chacal/pcbs/MS88SF2 eInk display/MS88SF2 eInk display v2.kicad_pcb

## KiCad design MS88SF2 eInk display/MS88SF2 eInk display v2.kicad_pcb (2021-03-07)

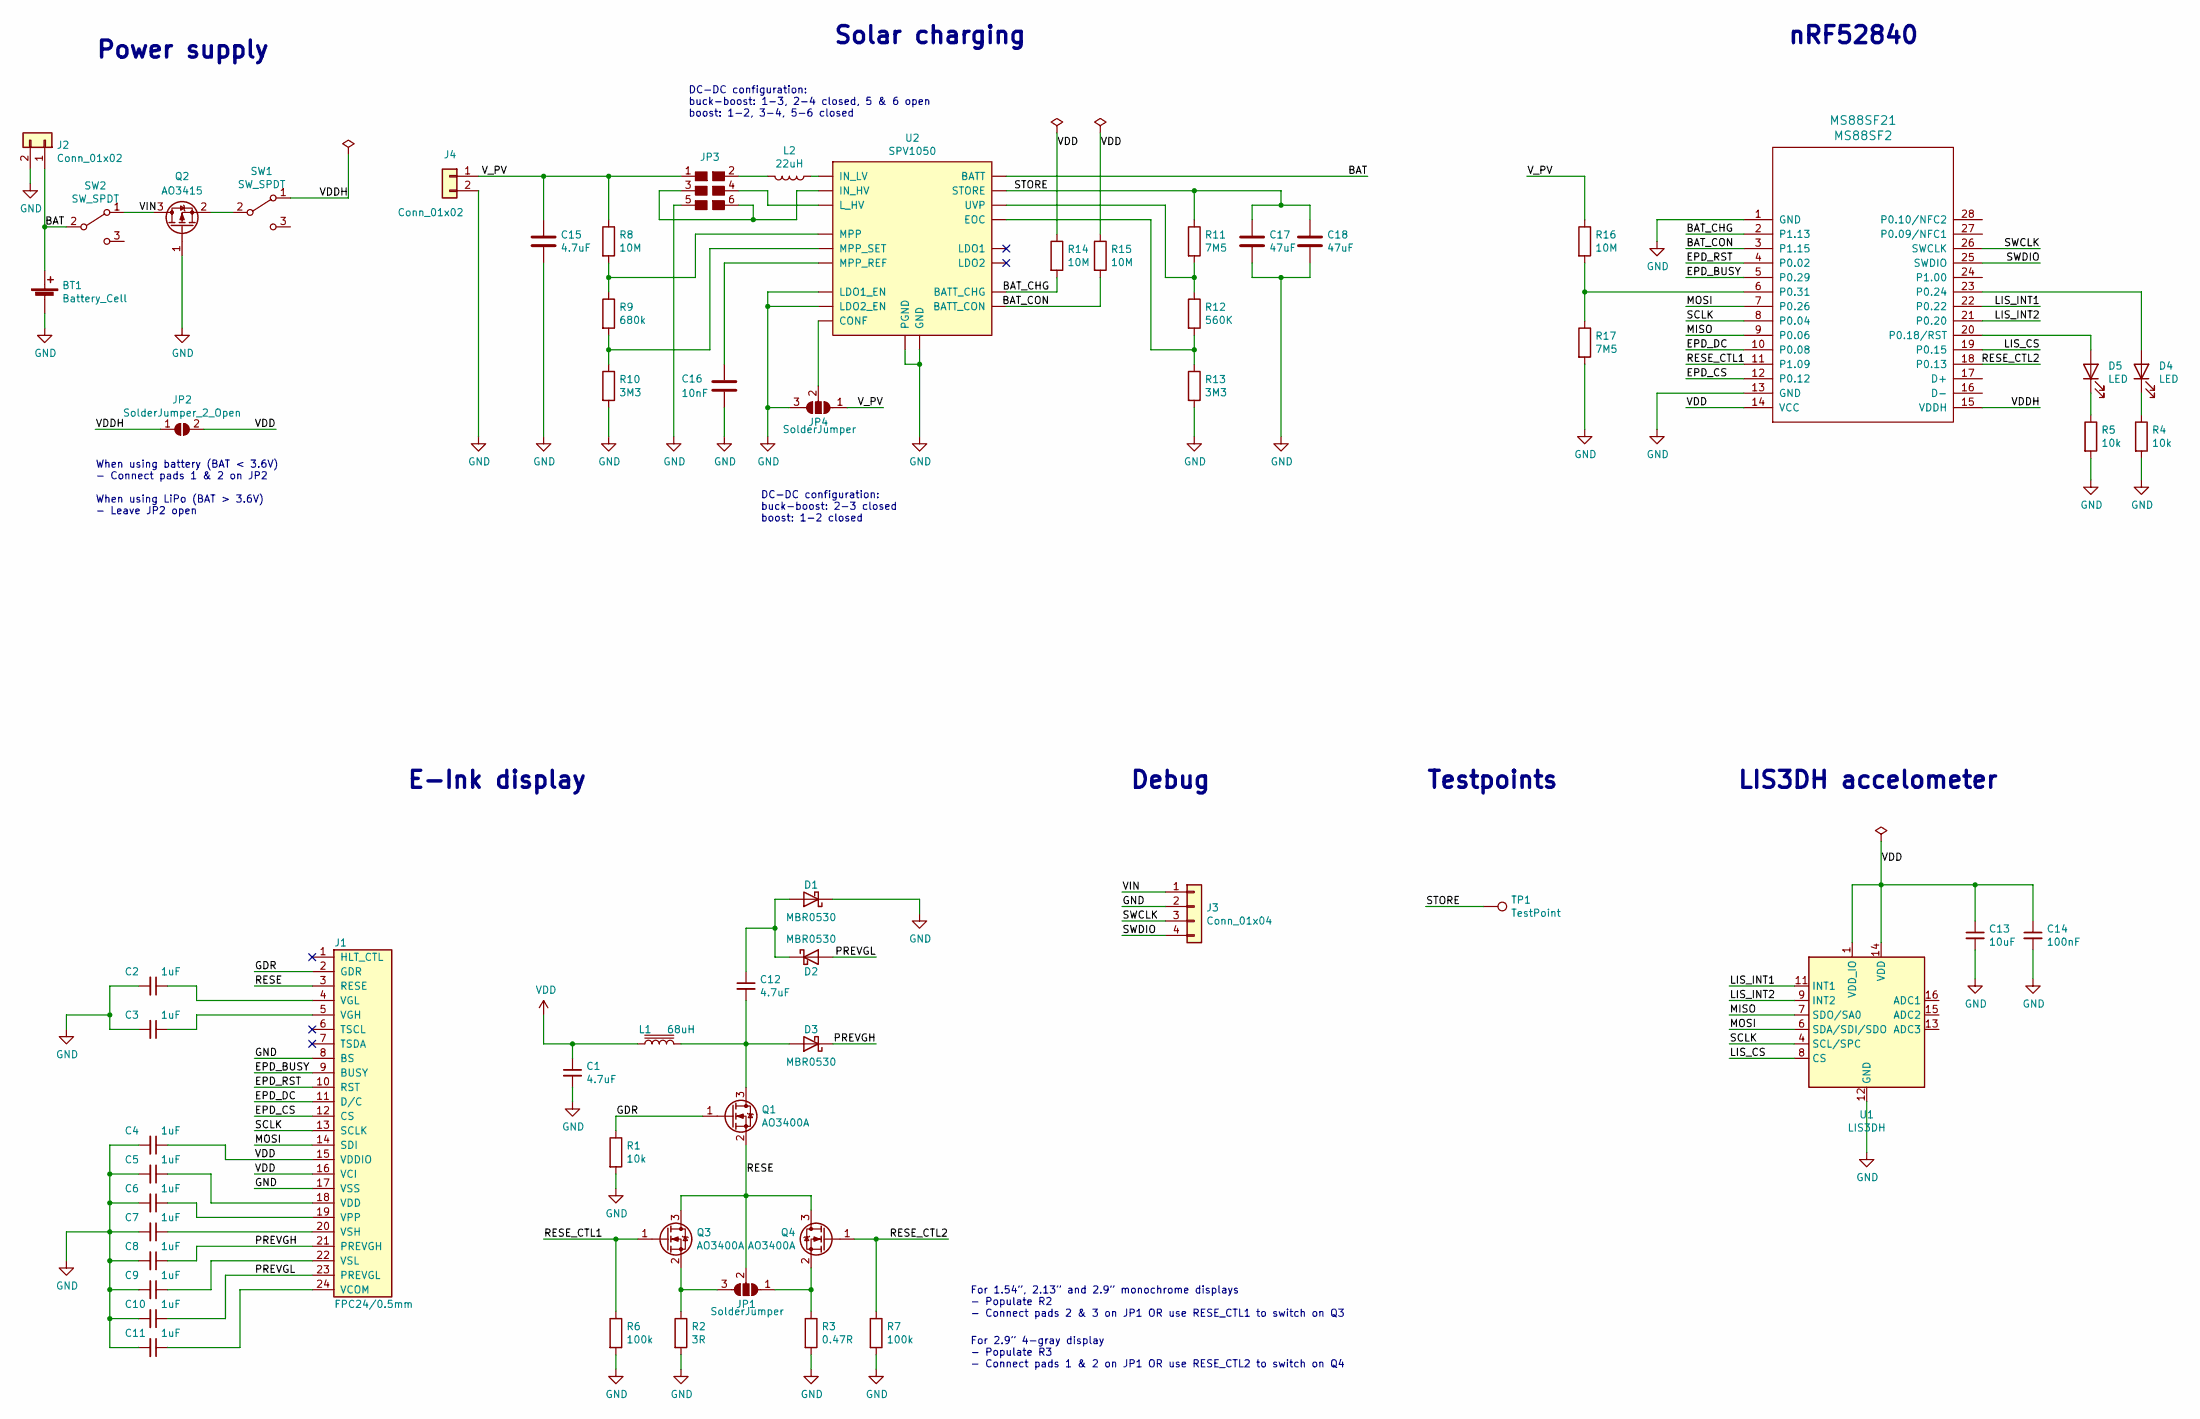
[picture p1: schematic MS88SF2 eInk display v2.sch]

Parts:
BT1: Battery_Cell; CR2032_holder
C1, C12, C15: 4.7uF; C_0805_2012Metric
C2, C3, C4, C5, C6, C7, C8, C9, C10, C11: 1uF; C_0805_2012Metric
C13: 10uF; CP_Elec_4x5.3
C14: 100nF; C_0805_2012Metric
C16: 10nF; C_0805_2012Metric
C17, C18: 47uF; C_0805_2012Metric
D1, D2, D3: MBR0530; D_SOD-123F
D4, D5: LED; LED_0805_2012Metric
J1: FPC24/0.5mm; FPC-24-0.50mm-top-contact
J2, J4: Conn_01x02; JST_PH_S2B-PH-K_1x02_P2.00mm_Horizontal
J3: Conn_01x04; PinSocket_1x04_P1.27mm_Vertical_SMD_Pin1Left
JP1, JP4: SolderJumper; SolderJumper-3_P1.3mm_Open_RoundedPad1.0x1.5mm
JP2: SolderJumper_2_Open; SolderJumper-2_P1.3mm_Open_RoundedPad1.0x1.5mm
JP3: SolderJumper_6_Bridged36; SolderJumper-6_P1.1mm_Open_Pad0.8x0.8mm
L1: 68uH; CD43
L2: 22uH; CD43
MS88SF21: MS88SF2
Q1, Q3, Q4: AO3400A; SOT-23
Q2: AO3415; SOT-23
R1: 10k; R_0603_1608Metric
R2: 3R; R_0603_1608Metric_Pad1.05x0.95mm_HandSolder
R3: 0.47R; R_0603_1608Metric
R4, R5: 10k; R_0603_1608Metric_Pad1.05x0.95mm_HandSolder
R6, R7: 100k; R_0603_1608Metric_Pad1.05x0.95mm_HandSolder
R8, R14, R15: 10M; R_0805_2012Metric
R9: 680k; R_0805_2012Metric
R10, R13: 3M3; R_0805_2012Metric
R11: 7M5; R_0805_2012Metric
R12: 560K; R_0805_2012Metric
R16: 10M; R_0603_1608Metric_Pad1.05x0.95mm_HandSolder
R17: 7M5; R_0603_1608Metric_Pad1.05x0.95mm_HandSolder
SW1, SW2: SW_SPDT; SW_SPDT_PCM12
TP1: TestPoint; TestPoint_Pad_D1.5mm
U1: LIS3DH; LGA-16_3x3mm_P0.5mm_3x5_hand_solder
U2: SPV1050; UQFN-20-1EP_3x3mm_P0.4mm_EP1.85x1.85mm_handsolder

Connections:
/BAT: BT1.1 (+), J2.1, SW2.2 (B), U2.14 (BATT)
/BAT_CHG: MS88SF21.2 (P1.13), R14.2, U2.7 (BATT_CHG)
/BAT_CON: MS88SF21.3 (P1.15), R15.2, U2.8 (BATT_CON)
/EPD_BUSY: J1.9 (BUSY), MS88SF21.5 (P0.29)
/EPD_CS: J1.12 (CS), MS88SF21.12 (P0.12)
/EPD_DC: J1.11 (D/C), MS88SF21.10 (P0.08)
/EPD_RST: J1.10 (RST), MS88SF21.4 (P0.02)
/GDR: J1.2 (GDR), Q1.1 (G), R1.1
/LIS_CS: MS88SF21.19 (P0.15), U1.8 (CS)
/LIS_INT1: MS88SF21.22 (P0.22), U1.11 (INT1)
/LIS_INT2: MS88SF21.21 (P0.20), U1.9 (INT2)
/MISO: MS88SF21.9 (P0.06), U1.7 (SDO/SA0)
/MOSI: J1.14 (SDI), MS88SF21.7 (P0.26), U1.6 (SDA/SDI/SDO)
/PREVGH: C8.1, D3.1 (K), J1.21 (PREVGH)
/PREVGL: C10.1, D2.2 (A), J1.23 (PREVGL)
/RESE: J1.3 (RESE), JP1.2 (C), Q1.2 (S), Q3.3 (D), Q4.3 (D)
/RESE_CTL1: MS88SF21.11 (P1.09), Q3.1 (G), R6.1
/RESE_CTL2: MS88SF21.18 (P0.13), Q4.1 (G), R7.1
/SCLK: J1.13 (SCLK), MS88SF21.8 (P0.04), U1.4 (SCL/SPC)
/STORE: C17.1, C18.1, R11.1, TP1.1, U2.15 (STORE)
/SWCLK: J3.3, MS88SF21.26 (SWCLK)
/SWDIO: J3.4, MS88SF21.25 (SWDIO)
/VDDH: JP2.1 (A), MS88SF21.15 (VDDH), SW1.1 (A)
/VIN: J3.1, Q2.3 (D), SW2.1 (A)
/V_PV: C15.1, J4.1, JP3.1, JP4.1 (A), R8.1, R16.1
GND: BT1.2 (-), C1.2, C2.2, C3.2, C4.2, C5.2, C6.2, C7.2, C8.2, C9.2, C10.2, C11.2, C13.2, C14.2, C15.2, C16.2, C17.2, C18.2, D1.1 (K), J1.8 (BS), J1.17 (VSS), J2.2, J3.2, J4.2, JP3.5, JP4.3 (B), MS88SF21.1 (GND), MS88SF21.13 (GND), Q2.1 (G), R1.2, R2.2, R3.2, R4.2, R5.2, R6.2, R7.2, R10.2, R13.2, R17.2, U1.5 (GND), U1.10 (GND), U1.12 (GND), U2.4 (GND), U2.5 (LDO1_EN), U2.6 (LDO2_EN), U2.18 (PGND)
unnamed: C2.1, J1.4 (VGL)
unnamed: C3.1, J1.5 (VGH)
unnamed: C5.1, J1.18 (VDD)
unnamed: C6.1, J1.19 (VPP)
unnamed: C7.1, J1.20 (VSH)
unnamed: C9.1, J1.22 (VSL)
unnamed: C11.1, J1.24 (VCOM)
unnamed: C12.1, D1.2 (A), D2.1 (K)
unnamed: C12.2, D3.2 (A), L1.2, Q1.3 (D)
unnamed: C16.1, U2.3 (MPP_REF)
unnamed: D4.1 (K), R4.1
unnamed: D4.2 (A), MS88SF21.23 (P0.24)
unnamed: D5.1 (K), R5.1
unnamed: D5.2 (A), MS88SF21.20 (P0.18/RST)
unnamed: JP1.1 (A), Q4.2 (S), R3.1
unnamed: JP1.3 (B), Q3.2 (S), R2.1
unnamed: JP3.2, L2.2
unnamed: JP3.3, JP3.6, U2.20 (IN_HV)
unnamed: JP3.4, U2.19 (L_HV)
unnamed: JP4.2 (C), U2.13 (CONF)
unnamed: L2.1, U2.16 (IN_LV)
unnamed: MS88SF21.6 (P0.31), R16.2, R17.1
unnamed: Q2.2 (S), SW1.2 (B)
unnamed: R8.2, R9.1, U2.1 (MPP)
unnamed: R9.2, R10.1, U2.2 (MPP_SET)
unnamed: R11.2, R12.1, U2.10 (UVP)
unnamed: R12.2, R13.1, U2.9 (EOC)
VDD: C1.1, C4.1, C13.1, C14.1, J1.15 (VDDIO), J1.16 (VCI), JP2.2 (B), L1.1, MS88SF21.14 (VCC), R14.1, R15.1, U1.1 (VDD_IO), U1.14 (VDD)

Notes on the sheet:
For 2.9” 4-gray display - Populate R3 - Connect pads 1 & 2 on JP1 OR use RESE_CTL2 to switch on Q4
For 1.54”, 2.13” and 2.9” monochrome displays - Populate R2 - Connect pads 2 & 3 on JP1 OR use RESE_CTL1 to switch on Q3
When using battery (BAT < 3.6V) - Connect pads 1 & 2 on JP2 When using LiPo (BAT > 3.6V) - Leave JP2 open
LIS3DH accelometer
Testpoints
nRF52840
E-Ink display
Debug
Power supply
DC-DC configuration: buck-boost: 1-3, 2-4 closed, 5 & 6 open boost: 1-2, 3-4, 5-6 closed
DC-DC configuration: buck-boost: 2-3 closed boost: 1-2 closed
Solar charging

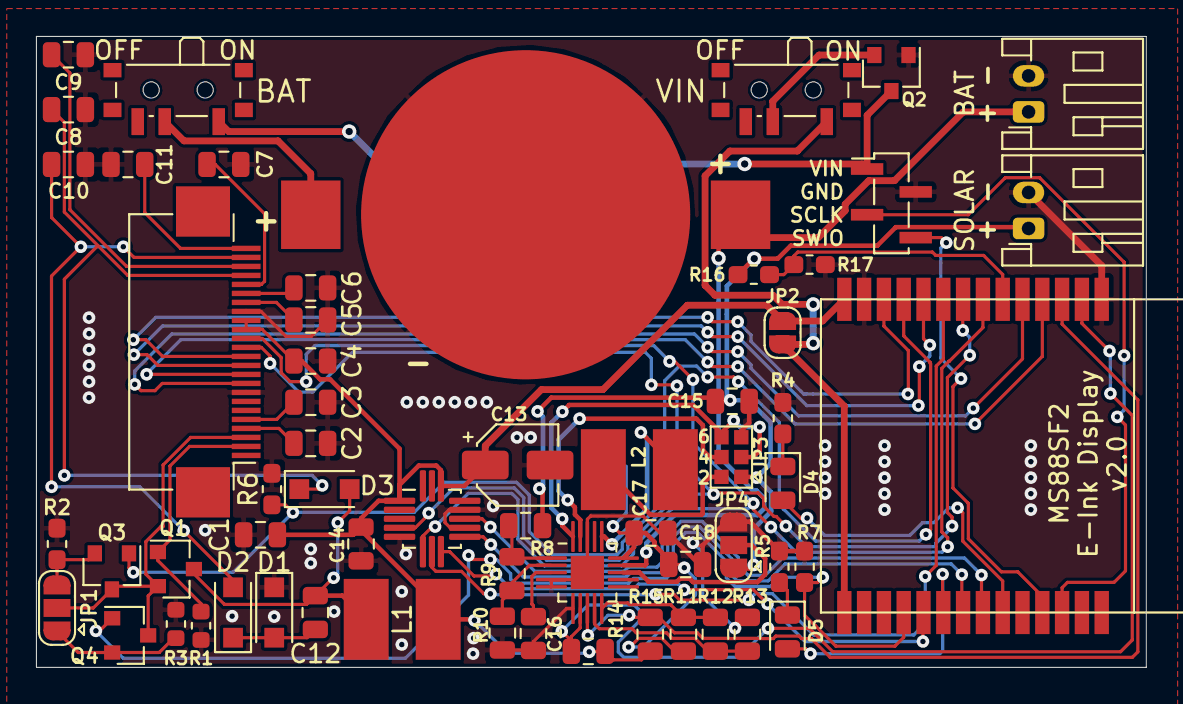
[picture p2: board MS88SF2 eInk display v2.kicad_pcb from above]

Board: 2 copper layers, 61.7 x 35.1 mm, 61 parts (1 on the bottom side), 54 nets.
